glidernet/ogn-tracker/README.md

OGN_Proto
=========

OGN Prototype tracker SW, documentation and other files required to create prototype tracker compatible with Open Glider Network.

Hardware
========
Prototype tracker uses four different hardware components:
- NUCLEO-L152RE prototype board from STM,
- Spirit1 module,
- GPS module,
- Baseboard to hold above in one place.

All parts (except NUCLEO) are created by OGN team, documentation available in doc/ 

Software
========
Currently SW is developed using:
- GNU Tools for ARM Embedded Processors: https://launchpad.net/gcc-arm-embedded/
- standalone makefile is as well available

Status
======
Two prototype trackers are transmitting and are being received by OGN station.
