glidernet/ogn-tracker/doc/OGN-Tracker-sch.pdf

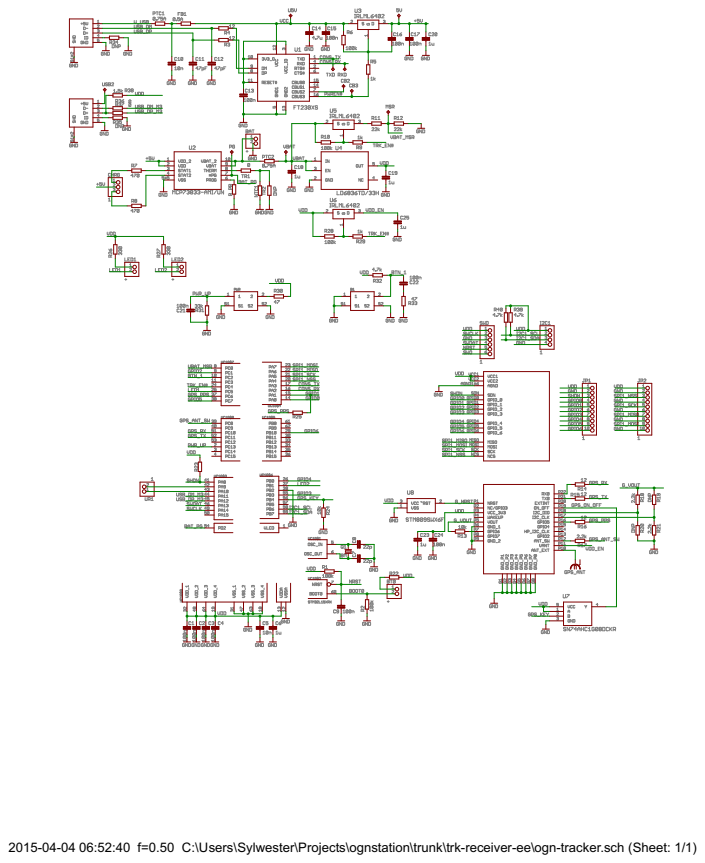
[picture p8: page 1]

2015-04-04 06:52:40 f=0.50 C:\Users\Sylwester\Projects\ognstation\trunk\trk-receiver-ee\ogn-tracker.sch (Sheet: 1/1)
