glidernet/ogn-tracker/(commit log)

2014-09-10 Initial commit.
    LD2 blinking
    [OGN_Proto_pins.ods]
2014-09-12 Console & USART driver added.
    Initial console task, USART2 driver
2014-09-15 GPS USART driver added.
    NMEA sentences could be also provided by console (from Condor).
2014-09-24 Tracker options stored in EEPROM
    Mechanism for storing options in EEPROM introduced.
    Current options: USART speeds.
2014-10-02 SPI1 driver
    SPI bus driver. SPI1 command added.
2014-10-02 SPI driver files moved
2014-10-02 Spirit1 attached to SPI bus
    Spirit1 module could be queried using SPI1 command
2014-10-03 Spirit1 API library connected
    Spirit1 configured - if not present green led will blink.
2014-10-04 sprintf() does not work with float formats, gps_pos command prints only the date/time
    [commands.c, console.c, ogn.h]
2014-10-04 Improved printout for gps_pos command
2014-10-05 Some bugs fixed in NMEA interpretation
    [ogn.h]
2014-10-05 Pin description updated with new devices
    Speaker, batt. chrg. control.
    [OGN_Proto_pins.ods]
2014-10-09 Bug fixed in set_acft_id
    [commands.c]
2014-10-09 Code to set AcftID was missing - fixed
    [options.c]
2014-10-11 flash.cfg file for openocd
    [flash.cfg]
2014-10-12 IdleHook (but empty) for RTOS, changing TxPower has real effect now
    [flash.cfg]
2014-10-12 xtal_corr and freq_ofs added to correct for crystal offset
    [commands.c, options.c, options.h, spirit1.c]
2014-10-12 make single command to print and to set a parameter
2014-10-12 add comment 'after a reset' to xtal_corr and freq_ofs
    [commands.c]
2014-10-13 HPT timer simple scheduling
2014-10-14 Correct makefile, add reset.cfg
    [reset.cfg]
2014-10-20 gps_lib fix, not tested
    [gps.c, ogn.h, ogn_lib.cpp, ogn_lib.h]
2014-10-20 Fixed some bugs, transmits again
    [control.c, ogn_lib.cpp]
2014-10-22 Fix bug in Spirit1 library for correct setting of channel separation, crystal correction still needs to be fixed
    [SPIRIT_Radio.c, SPIRIT_Radio.h]
2014-10-23 spirit1_dk: crystal correction [ppm] has been fixed
    [SPIRIT_Radio.c]
2014-11-03 SPI1 transfer fixes
    Better SPI transfer synchro.
    [spi.c]
2014-11-10 Instability fix
    Occasionally, IRQ could happen between SPI DMA TX/RX triggers - this
    resulted in delayed DMA RX start and unfinished DMA RX transfer.
    Fix: DMA RX should be triggered first so any delay in DMA TX start is
    not critical.
    [spi.c]
2014-11-19 Radio frame description, change to 4-byte Spirit1 sync word
2014-11-29 Precise TX power control, Spirit1 driver updates
    max_tx_power command added. It should be set to maximum power generated
    by Spirit1 module: 14.5dBm.
    Binary release of 0.1.0 version.
2014-11-30 GPS cold reset added
    command: gps_reset triggers GPS cold reset
    [commands.c, gps.c, gps.h, usart.c, usart.h]
2014-12-01 GPS power control
    1. gps_on/off commands added.
    2. gps_always_on command added.
    For GPS without power control use:
    gps_always_on en
2014-12-13 Soft power on/off
    Blue Button (B1) on Nucleo is now power button.
    With appropriate HW mods GPS, Spirit1 and MCU could be shut down
    completely (consuming few uA).
2014-12-21 LEDs/display control task added.
    Display task introduced.
    GPS status handled by display task.
    Power-up timeout.
2015-01-07 Add error pattern to Manchester decoding table
    [ogn_lib.cpp, spirit1.c]
2015-01-07 Correct Manchester packet decoding upon reception
    [control.c, spirit1.c, spirit1.h]
2015-01-11 SPIRIT1 library: small fix for C++
    [SPIRIT_Management.h]
2015-01-22 Spirit IRQ setup fix
    Spirit IRQ was configured too early.
    [commands.c, spirit1.c]
2015-03-29 OGN tracker buttons and LEDs support
    Updated for OGN tracker v1.
2015-04-04 GPS Antenna selector, schematics added.
    gps_ant int|ext command
2015-04-06 Voltages (Vdd, Vbat) measurement.
    volt
    Vdd: 3332[mV], Vbat: 4158[mV]
2015-04-16 Jammer mode
    mode jammer - simulates occupied channel.
    jam_ratio 0-100 - controls level.
    [commands.c, control.c, options.c, options.h, timer_const.h]
2015-04-29 Background task for voltage control and more.
2015-05-03 CPU temperature monitoring in background task
    cpu_temp command added.
2015-05-26 Tracker can start without RF module.
    If no SP1 module detected tracker will switch to MODE IDLE.
2015-06-14 Power off at low battery level
    Command:
    min_bat_lvl - power off voltage level (default 3.1V).
2015-07-02 Channel spacing fix
    Channel spacing fix was not applied after changing SP1 library.
    [SPIRIT_Radio.c, commands.c]
2016-02-01 1. Baro bit not cleared in output packet. 2. GPS bug (lack of CRC) detection and workaround.
    [gps.c, ogn.h, spirit1.c]
